MiniPic/DMX_Board_MultiV1/Top.PNG

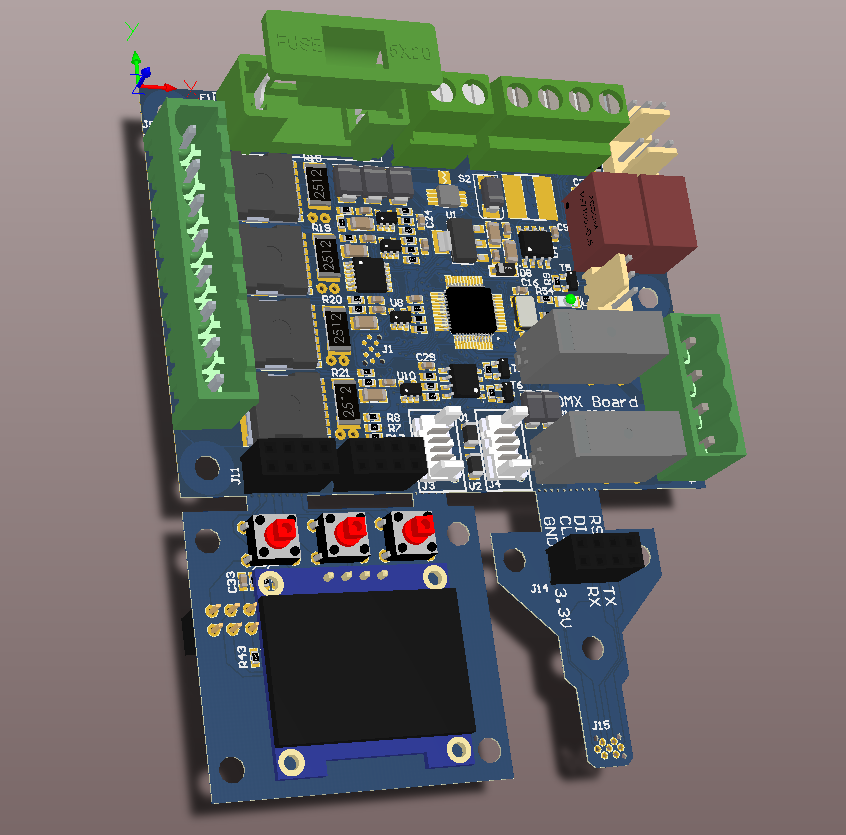
Top.PNG
