MiniPic/DMX_Board_MultiV1/Bottom.PNG

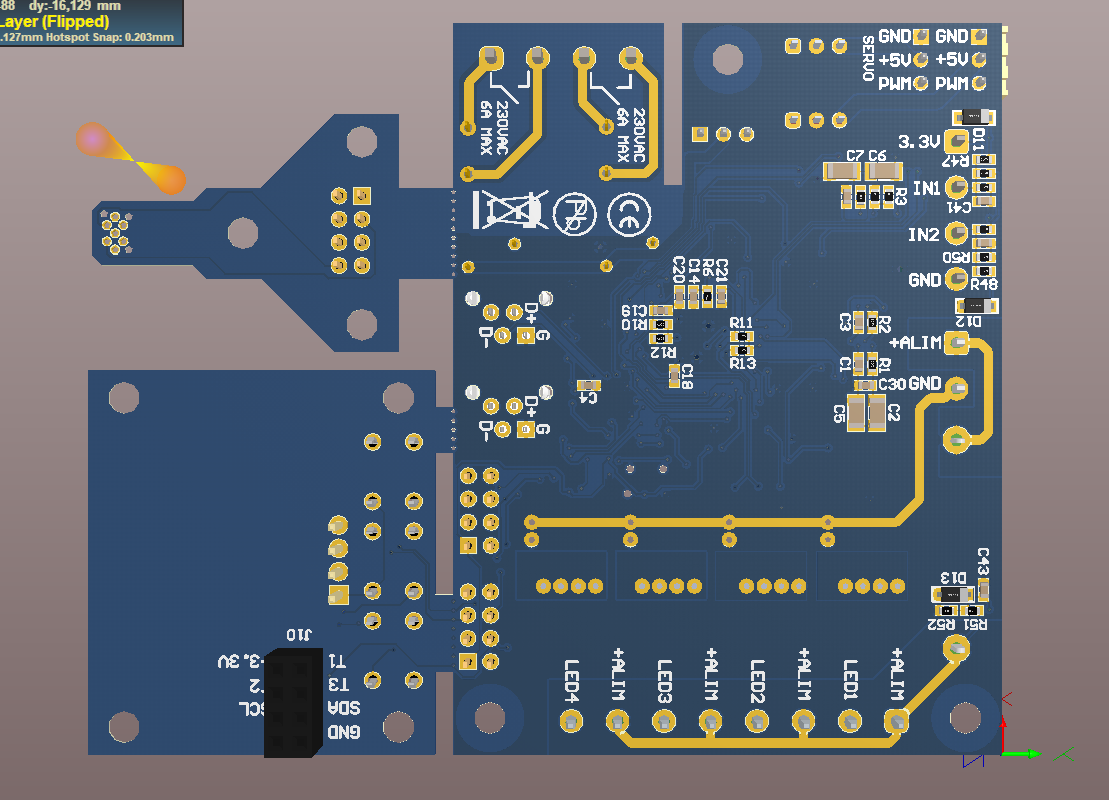
Bottom.PNG
