MiniPic/DMX_Board_MultiV1/README.md

# DMX_Board_MultiV1
DMX 512 Board hardware and software source. 

Board with : 
- 4 LED controle (10A max)
- 2 relays output
- 2 servo control
- 2 inputs
- extend by I2C
- OLED display
- 1 FAN outptu control

Software:
- Currently in progress
