MiniPic/DMX_Board_MultiV1/PCB/Display.SLDPRT

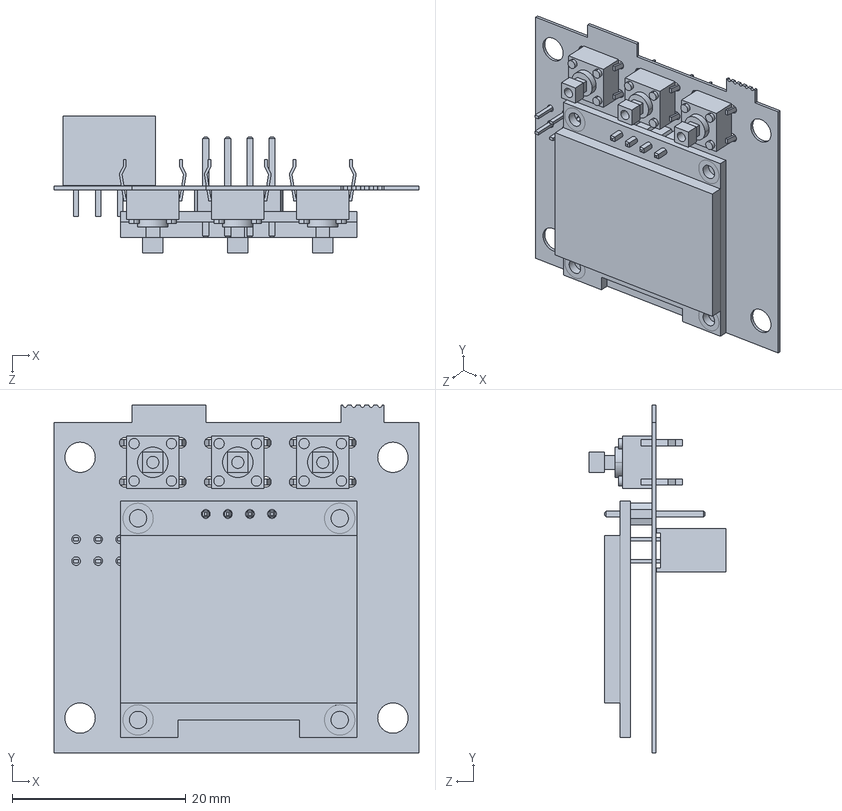
[picture p4: CAD file, 2020-05-01]
PCB/Display.SLDPRT
42.0 x 40.0 x 15.8 mm
