MiniPic/DMX_Board_MultiV1/(list of files, drawings)

Other design files:
PCB/Decoupe_DMX.PrjPcb
PCB/IHM.SchDoc
PCB/MCU.SchDoc
PCB/Mechanical.SchDoc
PCB/Outputs.SchDoc
PCB/Power_Supply.SchDoc
PCB/ProgTool.SchDoc
