MiniPic/DMX_Board_MultiV1/Firmware/DMX_Decoupe/DMX_Decoupe.ioc

Mcu.UserName=STM32F103C8Tx
PA0-WKUP.GPIO_Label=CURRENT1
PA0-WKUP.Signal=ADCx_IN0
PA1.GPIO_Label=CURRENT2
PA1.Signal=ADCx_IN1
PA10.GPIO_Label=USART_RX_DUBUG
PA10.Signal=USART1_RX
PA13.Signal=SYS_JTMS-SWDIO
PA14.Signal=SYS_JTCK-SWCLK
PA15.Signal=S_TIM2_CH1_ETR
PA2.GPIO_Label=DMX_OUT
PA2.Signal=USART2_TX
PA3.GPIO_Label=DMX_IN
PA3.Signal=USART2_RX
PA4.GPIO_Label=CURRENT3
PA4.Signal=ADCx_IN4
PA5.GPIO_Label=CURRENT4
PA5.Signal=ADCx_IN5
PA6.GPIO_Label=IN1
PA6.Signal=GPIO_Input
PA7.GPIO_Label=IN2
PA7.Signal=GPIO_Input
PA9.GPIO_Label=USART_TX_DUBUG
PA9.Signal=USART1_TX
PB0.GPIO_Label=T1
PB0.Signal=GPIO_Input
PB1.GPIO_Label=VOLTAGE
PB1.Signal=ADCx_IN9
PB10.Signal=S_TIM2_CH3
PB11.Signal=S_TIM2_CH4
PB12.GPIO_Label=T2
PB12.Signal=GPIO_Input
PB13.GPIO_Label=T3
PB13.Signal=GPIO_Input
PB14.GPIO_Label=REL1
PB14.Signal=GPIO_Output
PB15.GPIO_Label=REL2
PB15.Signal=GPIO_Output
PB3.Signal=S_TIM2_CH2
PB4.GPIO_Label=FAN
PB4.Signal=GPIO_Output
PB6.GPIO_Label=S1
PB6.Signal=S_TIM4_CH1
PB7.GPIO_Label=S2
PB7.Signal=S_TIM4_CH2
PB8.GPIO_Label=SCL_IO
PB8.Signal=GPIO_Output
PB9.GPIO_Label=SDA_IO
PB9.Signal=GPIO_Output
PC13-TAMPER-RTC.GPIO_Label=LED_V
PC13-TAMPER-RTC.Signal=GPIO_Output
PC14-OSC32_IN.GPIO_Label=LED_R
PC14-OSC32_IN.Signal=GPIO_Output
PC15-OSC32_OUT.GPIO_Label=RE_DE
PC15-OSC32_OUT.Signal=GPIO_Output
PD0-OSC_IN.Signal=RCC_OSC_IN
PD1-OSC_OUT.Signal=RCC_OSC_OUT
