MiniPic/DMX_Board_MultiV1/Firmware/DMX_Decoupe/Inc/main.h

#define LED_V_Pin GPIO_PIN_13
#define LED_V_GPIO_Port GPIOC
#define LED_R_Pin GPIO_PIN_14
#define LED_R_GPIO_Port GPIOC
#define RE_DE_Pin GPIO_PIN_15
#define RE_DE_GPIO_Port GPIOC
#define CURRENT1_Pin GPIO_PIN_0
#define CURRENT1_GPIO_Port GPIOA
#define CURRENT2_Pin GPIO_PIN_1
#define CURRENT2_GPIO_Port GPIOA
#define DMX_OUT_Pin GPIO_PIN_2
#define DMX_OUT_GPIO_Port GPIOA
#define DMX_IN_Pin GPIO_PIN_3
#define DMX_IN_GPIO_Port GPIOA
#define CURRENT3_Pin GPIO_PIN_4
#define CURRENT3_GPIO_Port GPIOA
#define CURRENT4_Pin GPIO_PIN_5
#define CURRENT4_GPIO_Port GPIOA
#define IN1_Pin GPIO_PIN_6
#define IN1_GPIO_Port GPIOA
#define IN2_Pin GPIO_PIN_7
#define IN2_GPIO_Port GPIOA
#define T1_Pin GPIO_PIN_0
#define T1_GPIO_Port GPIOB
#define VOLTAGE_Pin GPIO_PIN_1
#define VOLTAGE_GPIO_Port GPIOB
#define T2_Pin GPIO_PIN_12
#define T2_GPIO_Port GPIOB
#define T3_Pin GPIO_PIN_13
#define T3_GPIO_Port GPIOB
#define REL1_Pin GPIO_PIN_14
#define REL1_GPIO_Port GPIOB
#define REL2_Pin GPIO_PIN_15
#define REL2_GPIO_Port GPIOB
#define USART_TX_DUBUG_Pin GPIO_PIN_9
#define USART_TX_DUBUG_GPIO_Port GPIOA
#define USART_RX_DUBUG_Pin GPIO_PIN_10
#define USART_RX_DUBUG_GPIO_Port GPIOA
#define FAN_Pin GPIO_PIN_4
#define FAN_GPIO_Port GPIOB
#define S1_Pin GPIO_PIN_6
#define S1_GPIO_Port GPIOB
#define S2_Pin GPIO_PIN_7
#define S2_GPIO_Port GPIOB
#define SCL_IO_Pin GPIO_PIN_8
#define SCL_IO_GPIO_Port GPIOB
#define SDA_IO_Pin GPIO_PIN_9
#define SDA_IO_GPIO_Port GPIOB
