MiniPic/DMX_Board_MultiV1/(commit log)

2020-12-11 First test on board
2020-12-11 V1.0 LED + SERVO + RELAY
